mertceyhaann/Independent-Projects/Project 1/Components.txt

STM NUCLEOF401RE
JGA12-N20B DC Motor
L298N Motor Driver
12.5V DC Adaptor
