mertceyhaann/Independent-Projects/Project 2/Components (Version 2).xlsx

Görev / Blok | Parça Kodu / Değer | Açıklama & Kılıf Tipi | Datasheet Bağlantısı | Fiyat
Senkron Kontrolcü | LM5122QMHX/NOPB | 65V, Current Mode, HTSSOP-20 (TI) | Datasheet İndir / Görüntüle (https://www.ti.com/lit/ug/snvu197/snvu197.pdf?ts=1784615175695) | 5.14 €
Güç İndüktörü | 7443641500 | 15 μH, 37A Doyum Akımı, WE-HCF 2818 (Würth) | Datasheet İndir / Görüntüle (https://www.we-online.com/catalog/datasheet/7443641500.pdf) | 8,57 €
Güç MOSFET (x2) | IPB017N06N3 G | 60V, 1.7 mΩ N-Kanal OptiMOS, D2PAK (Infineon) | Datasheet İndir / Görüntüle (https://www.infineon.com/dgdl/Infineon-IPB017N06N3-DS-v02_02-en.pdf?fileId=db3a30432103f6f101210940cc1a26f8) | 4,97 € x 2 = 9,94 €
Akım Şönt Direnci | WSLP25122L000FEA | 2 mΩ, 3W Metal Alaşım Direnç, 2512 Kılıf, %1 (Vishay) | Datasheet İndir / Görüntüle (https://www.vishay.com/docs/30122/wslp.pdf) | 1.23 €
Giriş Koruması (Inrush) | MF72-001.5D15 | NTC Termistör, Soğuk Direnç: 5Ω, DIP (Canthern) | Datasheet İndir / Görüntüle (https://www.cantherm.com/wp-content/uploads/2018/08/MF72_AUG_2018.pdf) | 1.20 €
Giriş Kapasitörü (x2) | UCD1V471MNL6GS | 470 μF, 35V Alüminyum Elektrolitik, SMD (8.3x10.5) (Nichicon) | Datasheet İndir / Görüntüle (https://www.mouser.com.tr/datasheet/3/497/1/e_ucd.pdf) | 1,14 € x 2 = 2,28 €
Çıkış Kapasitörü (x4) | 35SVPF120M | 120 μF, 35V Polymer OS-CON, SMD (6.3x5.9) (Panasonic) | Datasheet İndir / Görüntüle (https://industrial.panasonic.com/cdbs/www-data/pdf/AAB8000/AAB8000C177.pdf) | 2,03 € x 4 = 8,12 €
Çıkış HF Filtre (x2) | GRM31CR71H475KA12L | 4.7 μF, 50V, X7R MLCC, 1206 Kılıf (Murata) | Datasheet İndir / Görüntüle (https://eu.mouser.com/datasheet/3/76/1/GRM31CR71H475KA12_01A.pdf) | 0,28 € x 2 = 0,56 €
VCC Ana Kapasitör | GRM21BR71E105KA99L | 1 μF, 25V, X7R MLCC, 0805 Kılıf (Murata) | Datasheet İndir / Görüntüle (https://www.mouser.com.tr/datasheet/3/76/1/GRM21BR71E105KA99-01.pdf) | 0.15 €
BST, SS & RES Kap. (x3) | GRM21BR71H104KA01L | 100 nF, 50V, X7R MLCC, 0805 Kılıf (Murata) | Datasheet İndir / Görüntüle (https://www.mouser.com.tr/datasheet/3/76/2/GRM21BR71H104KA01_01.pdf) | 0,301 € x 3 = 0,903 €
COMP Ana Kapasitör | C0603C223K5RACTU | 22 nF, 50V, X7R MLCC, 0603 Kılıf (Kemet) | Datasheet İndir / Görüntüle (https://www.mouser.com.tr/datasheet/3/508/1/C0603C223K5RACTU.pdf) | 0.12 €
COMP HF Kapasitör | C0603C331K5RACTU | 330 pF, 50V, X7R MLCC, 0603 Kılıf (Kemet) | Datasheet İndir / Görüntüle (https://www.mouser.com.tr/datasheet/3/72/1/C0603C331K5RACTU.pdf) | 0.09 €
SLOPE Kapasitörü | GRM188R71E474KA12D | 0.47 μF, 25V, X7R MLCC, 0603 Kılıf (Murata) | Datasheet İndir / Görüntüle (https://pim.murata.com/asset/pim4/ceramicCapacitorSMD/GRM188R71E474KA12-01A-EN_PDF_CERAMICCAPACITORSMD) | 0.12 €
FB Üst Direnci | CR0805-FX-1913ELF | 191 kΩ, %1 Toleranslı SMD Direnç, 0805 (Bourns) | Datasheet İndir / Görüntüle (https://bourns.com/docs/product-datasheets/cr.pdf?sfvrsn=574d41f6_14) | 0.09 €
FB Alt Direnci | CRCW080510K0FKEA | 10 kΩ, %1 Toleranslı SMD Direnç, 0805 (Vishay) | Datasheet İndir / Görüntüle (https://www.vishay.com/docs/20035/dcrcwe3.pdf) | 0.09 €
RT (Frekans) Direnci | CRCW080536K5FKEA | 36.5 kΩ, %1 Toleranslı SMD Direnç, 0805 (Vishay) | Datasheet İndir / Görüntüle (https://www.vishay.com/docs/20035/dcrcwe3.pdf) | 0.09 €
UVLO Üst Direnci | CRCW080549K9FKEA | 49.9 kΩ, %1 Toleranslı SMD Direnç, 0805 (Vishay) | Datasheet İndir / Görüntüle (https://www.vishay.com/docs/20035/dcrcwe3.pdf) | 0.09 €
UVLO Alt Direnci | CRCW08058K06FKEA | 8.06 kΩ, %1 Toleranslı SMD Direnç, 0805 (Vishay) | Datasheet İndir / Görüntüle (https://www.vishay.com/docs/20035/dcrcwe3.pdf) | 0.09 €
COMP Direnci | CRCW080568K1FKEA | 68.1 kΩ, %1 Toleranslı SMD Direnç, 0805 (Vishay) | Datasheet İndir / Görüntüle (https://www.vishay.com/docs/20035/dcrcwe3.pdf) | 0.09 €
OPT (Pull-up) Direnci | CRCW0805100KFKEA | 100 kΩ, %1 Toleranslı SMD Direnç, 0805 (Vishay) | Datasheet İndir / Görüntüle (https://www.vishay.com/docs/20035/dcrcwe3.pdf) | 0.18 €
Gate Dirençleri (x2) | CRCW08054R70FKEAHP | 4.7 Ω, %1 Toleranslı SMD Direnç, 0805 (Vishay) | Datasheet İndir / Görüntüle (https://www.vishay.com/docs/20115/crcwhp.pdf) | 0,224 € x 2 = 0, 448 €
SLOPE Direnci | CRCW08058K06FKEA | 8.06 kΩ, %1 Toleranslı SMD Direnç, 0805 (Vishay) | Datasheet İndir / Görüntüle (https://www.vishay.com/docs/20035/dcrcwe3.pdf) | 0.09 €
VIN Kapasitörü | GRM21BR71H104KA01L | 100 nF, 50V, X7R MLCC, 0805 Kılıf (Murata) | Datasheet İndir / Görüntüle (https://www.mouser.com.tr/datasheet/3/76/2/GRM21BR71H104KA01_01.pdf) | 0.30 €
 |  |  |  | Toplam = 39,910 €
