mertceyhaann/Independent-Projects/(list of files, drawings)

Other design files:
Project 2/Altium/V1/PCB_Project.PrjPcb
Project 2/Altium/V1/Sheet1.SchDoc
Project 2/Altium/V2/Project_2/PCB1.PcbDoc
Project 2/Altium/V2/Project_2/Project_2.PrjPcb
Project 2/Altium/V2/Sheet2.SchDoc
Project 2/Altium/V2/V2.PrjPcb
