mertceyhaann/Independent-Projects/Project 1/STM32/Project9/Core/Src/main.c

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
/* Includes ------------------------------------------------------------------*/
#include "main.h"

TIM_HandleTypeDef htim1;
TIM_HandleTypeDef htim2;

UART_HandleTypeDef huart2;

/* USER CODE BEGIN PV */
int32_t encoder_count = 0;
int32_t last_encoder_count = 0;
float rpm = 0;
uint32_t last_time = 0;

/* USER CODE END PV */

void SystemClock_Config(void);
static void MX_GPIO_Init(void);
static void MX_TIM1_Init(void);
static void MX_TIM2_Init(void);
static void MX_USART2_UART_Init(void);
/**
  * @brief  The application entry point.
  * @retval int
  */
int main(void)
{

  /* MCU Configuration--------------------------------------------------------*/

  /* Reset of all peripherals, Initializes the Flash interface and the Systick. */
  HAL_Init();

  /* Configure the system clock */
  SystemClock_Config();

  /* Initialize all configured peripherals */
  MX_GPIO_Init();
  MX_TIM1_Init();
  MX_TIM2_Init();
  MX_USART2_UART_Init();
  /* USER CODE BEGIN 2 */
  // 1. Yönü ayarla (PA9=1, PC7=0 -> İleri)
  HAL_GPIO_WritePin(GPIOA, GPIO_PIN_9, GPIO_PIN_SET);
  HAL_GPIO_WritePin(GPIOC, GPIO_PIN_7, GPIO_PIN_RESET);

  // 2. PWM ve Encoder Birimlerini Başlat
  HAL_TIM_PWM_Start(&htim1, TIM_CHANNEL_1);
  HAL_TIM_Encoder_Start(&htim2, TIM_CHANNEL_ALL);

  // 3. İlk hızı düşük tut (%25 hız)
  __HAL_TIM_SET_COMPARE(&htim1, TIM_CHANNEL_1, 1000);
  /* USER CODE END 2 */

  /* Infinite loop */
  /* USER CODE BEGIN WHILE */
  while (1)
  {
	  if (HAL_GetTick() - last_time >= 100) // Her 100ms'de bir hesapla
	  {
	      encoder_count = (int32_t)TIM2->CNT; // Mevcut sayaç değerini al

	      // 100ms'deki değişim üzerinden RPM hesabı
	      // (PPR_toplam değerini motorunun özelliklerine göre güncelle)
	      float delta_pulse = (float)(encoder_count - last_encoder_count);
	      rpm = (delta_pulse / 440.0f) * 600.0f; // Örnek: PPR=440 (11*4*10 oranlı dişli)

	      last_encoder_count = encoder_count;
	      last_time = HAL_GetTick();
	  }

	  HAL_GPIO_TogglePin(GPIOA, GPIO_PIN_5); // Yeşil LED'i yak/söndür
	  HAL_Delay(500);                        // 500ms bekle
    /* USER CODE END WHILE */

    /* USER CODE BEGIN 3 */
  }
  /* USER CODE END 3 */
}

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
