mertceyhaann/Independent-Projects/(notices)

Notices in the files:
Project 1/STM32/Project9/Core/Src/main.c:
Copyright (c) 2026 STMicroelectronics.
All rights reserved.
This software is licensed under terms that can be found in the LICENSE file
